guilhermenovais/tp2-robotica/screenshots/C03.png

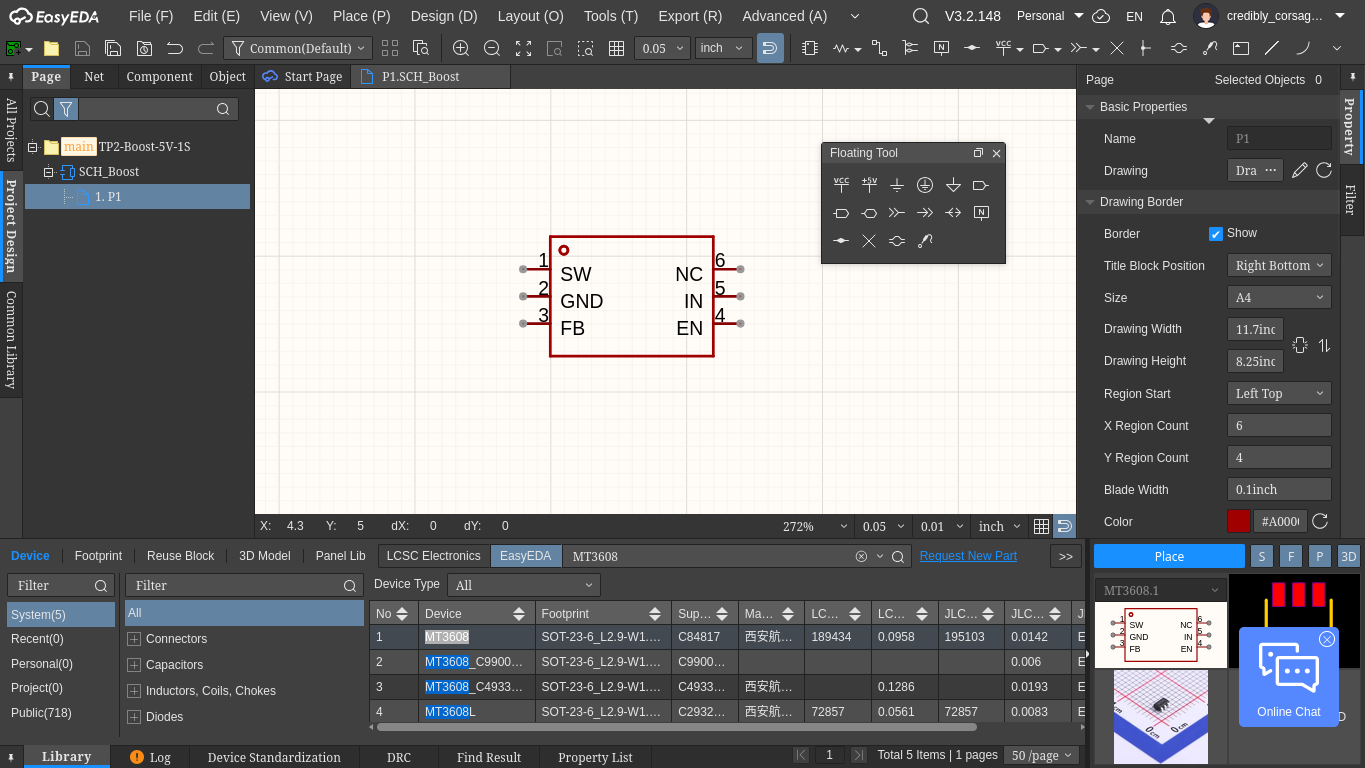
screenshots/C03.png
