guilhermenovais/tp2-robotica/screenshots/C04.png

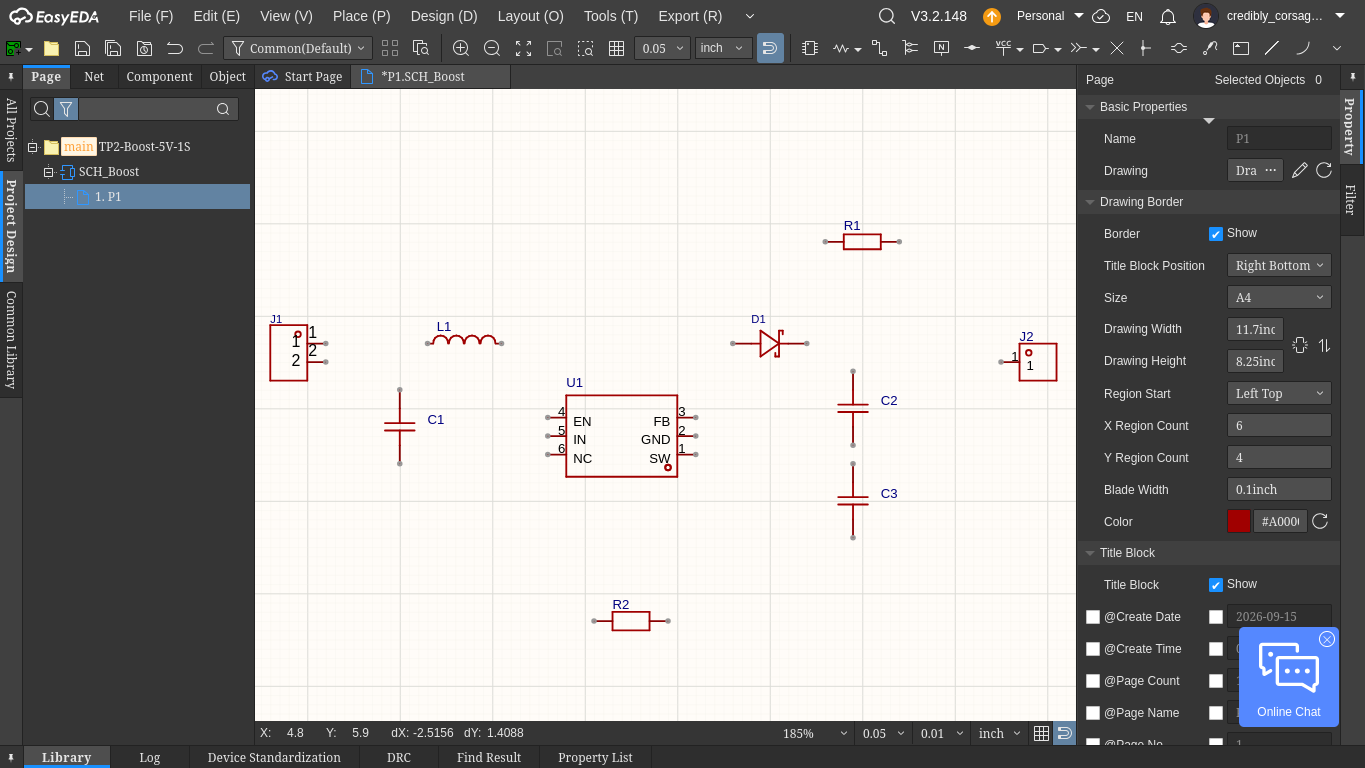
screenshots/C04.png
