guilhermenovais/tp2-robotica/screenshots/C09-antes-das-correcoes.png

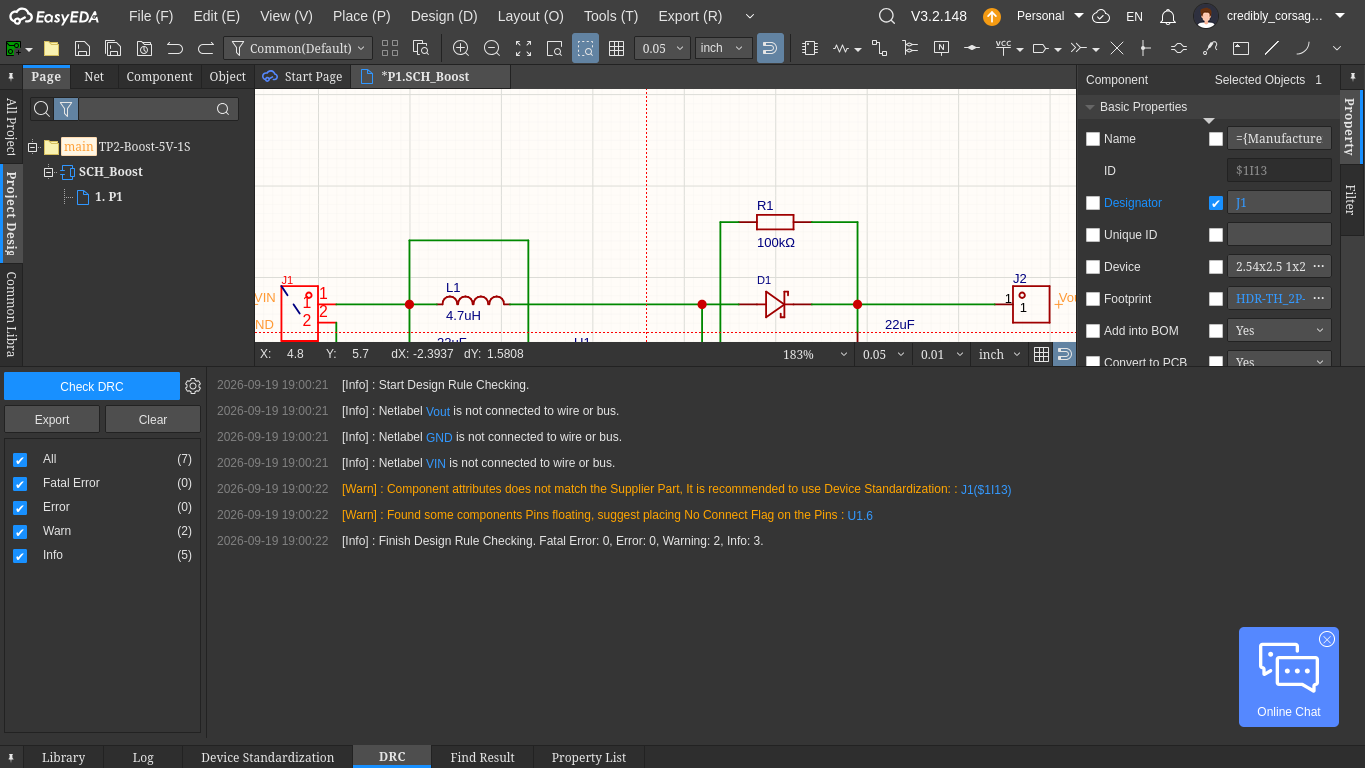
screenshots/C09-antes-das-correcoes.png
