guilhermenovais/tp2-robotica/screenshots/C09.png

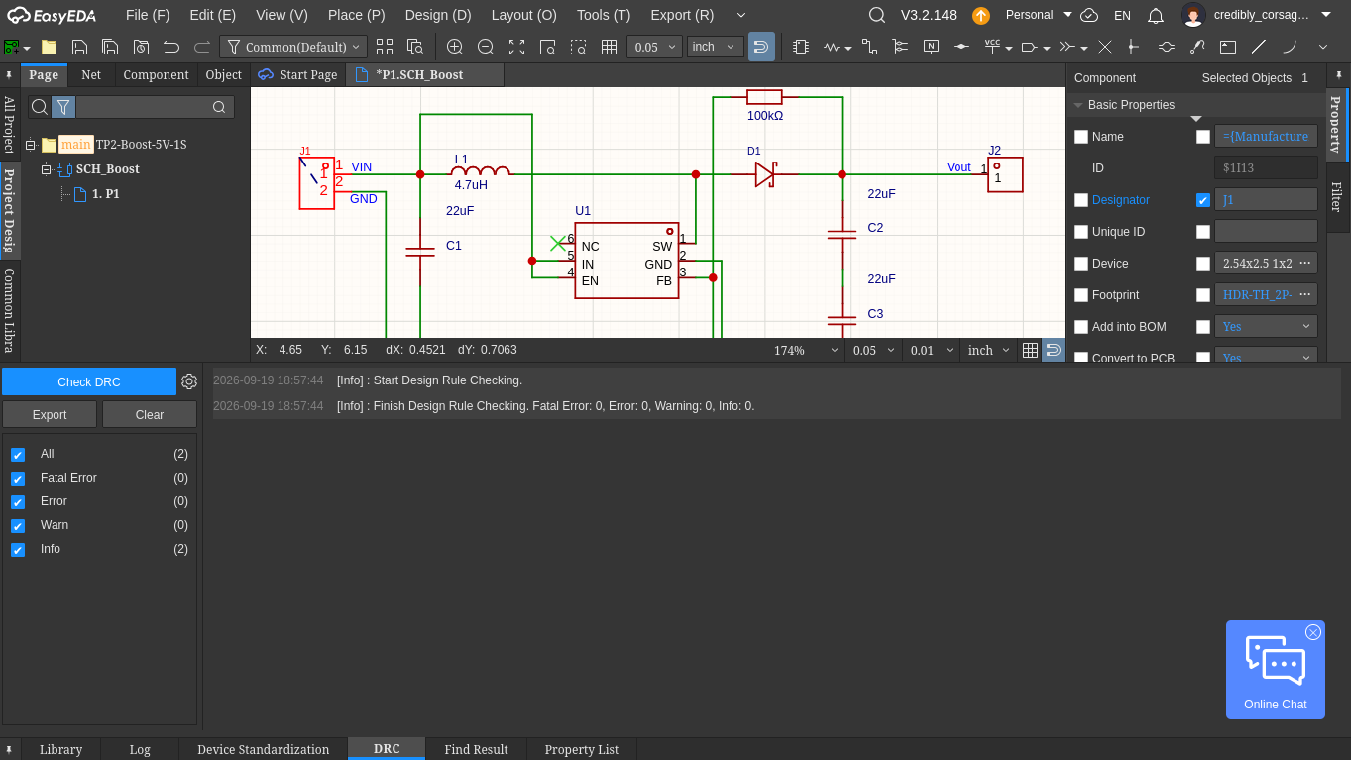
screenshots/C09.png
