guilhermenovais/tp2-robotica/screenshots/C12.png

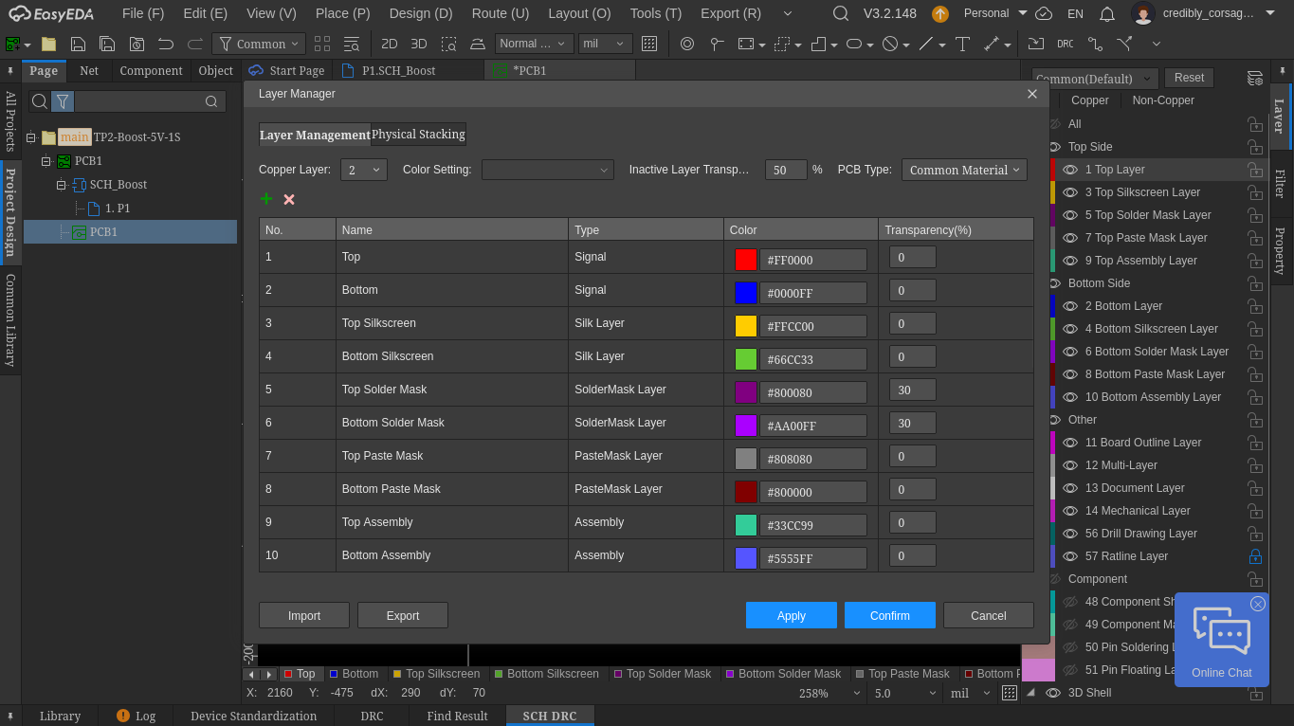
screenshots/C12.png
