guilhermenovais/tp2-robotica/screenshots/C14.png

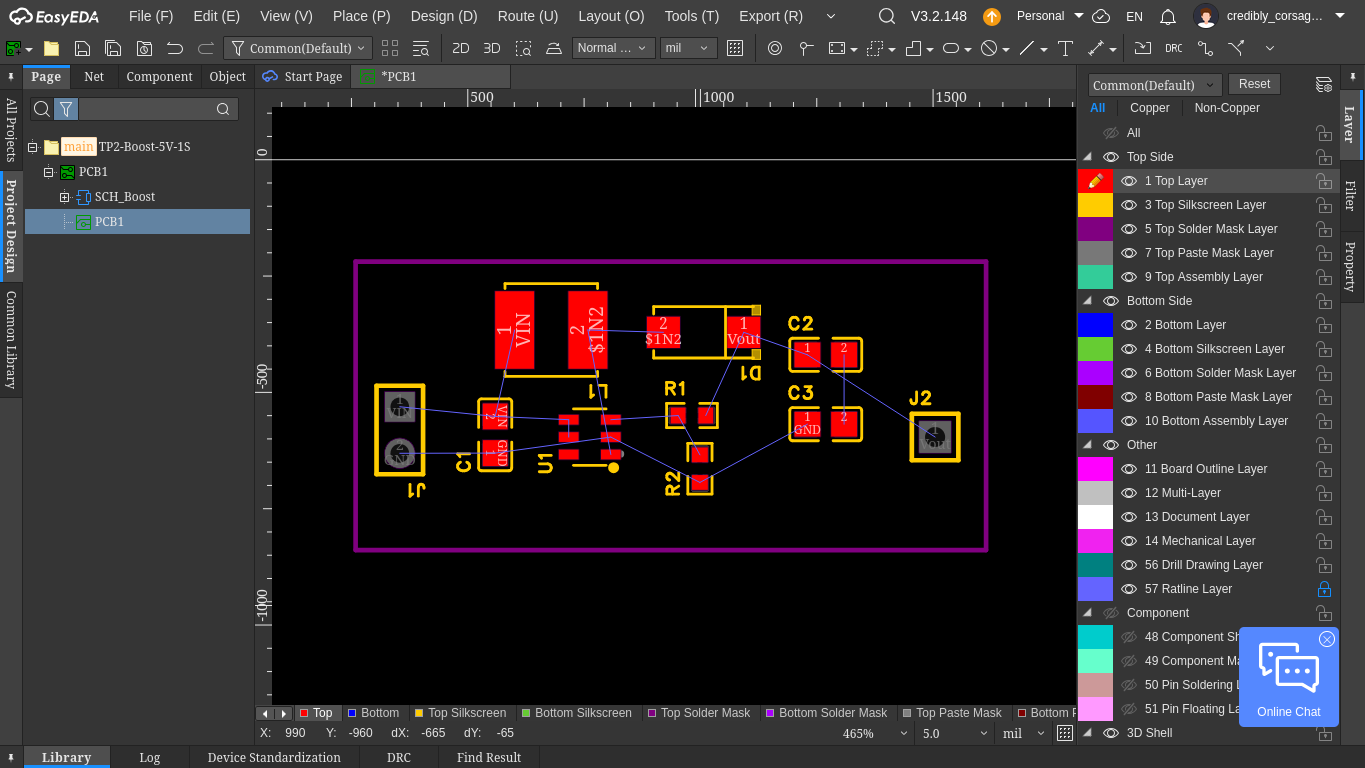
screenshots/C14.png
