guilhermenovais/tp2-robotica/screenshots/C15.png

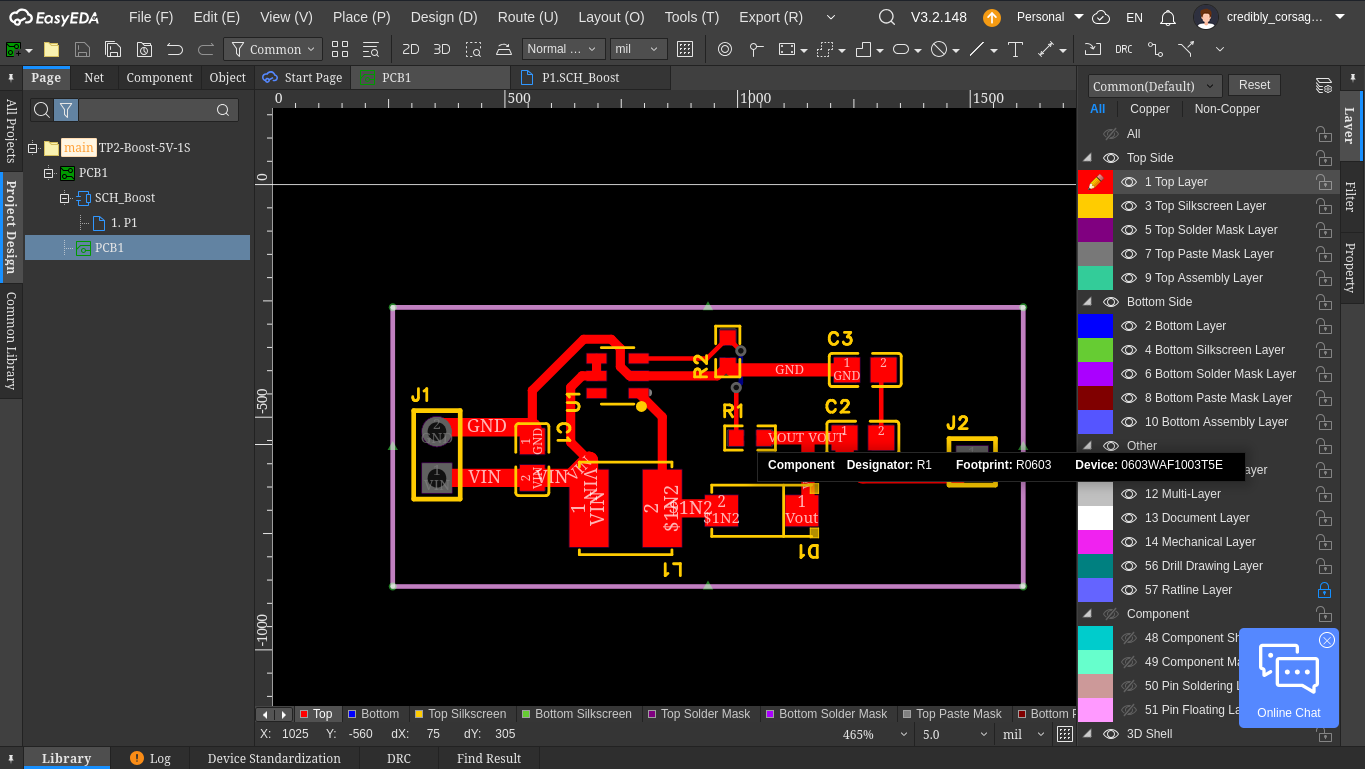
screenshots/C15.png
