guilhermenovais/tp2-robotica/screenshots/C17.png

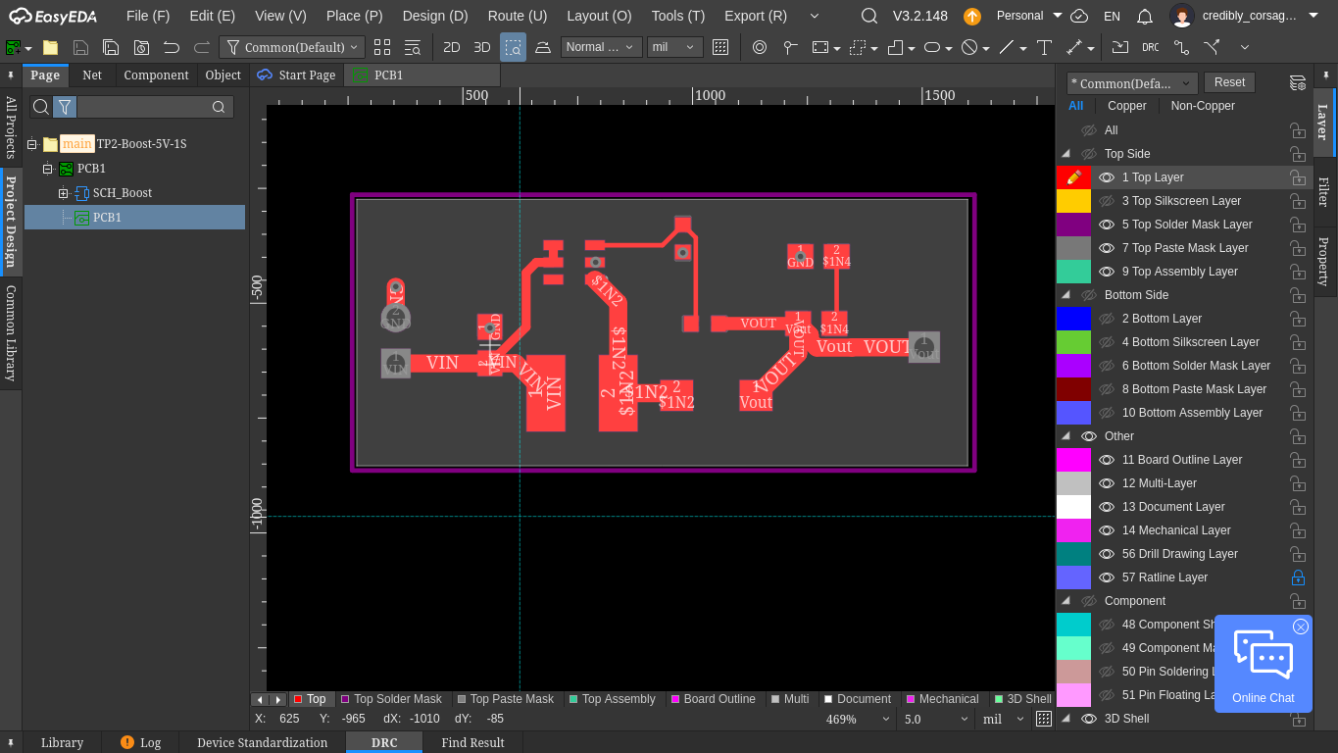
screenshots/C17.png
