guilhermenovais/tp2-robotica/screenshots/C18.png

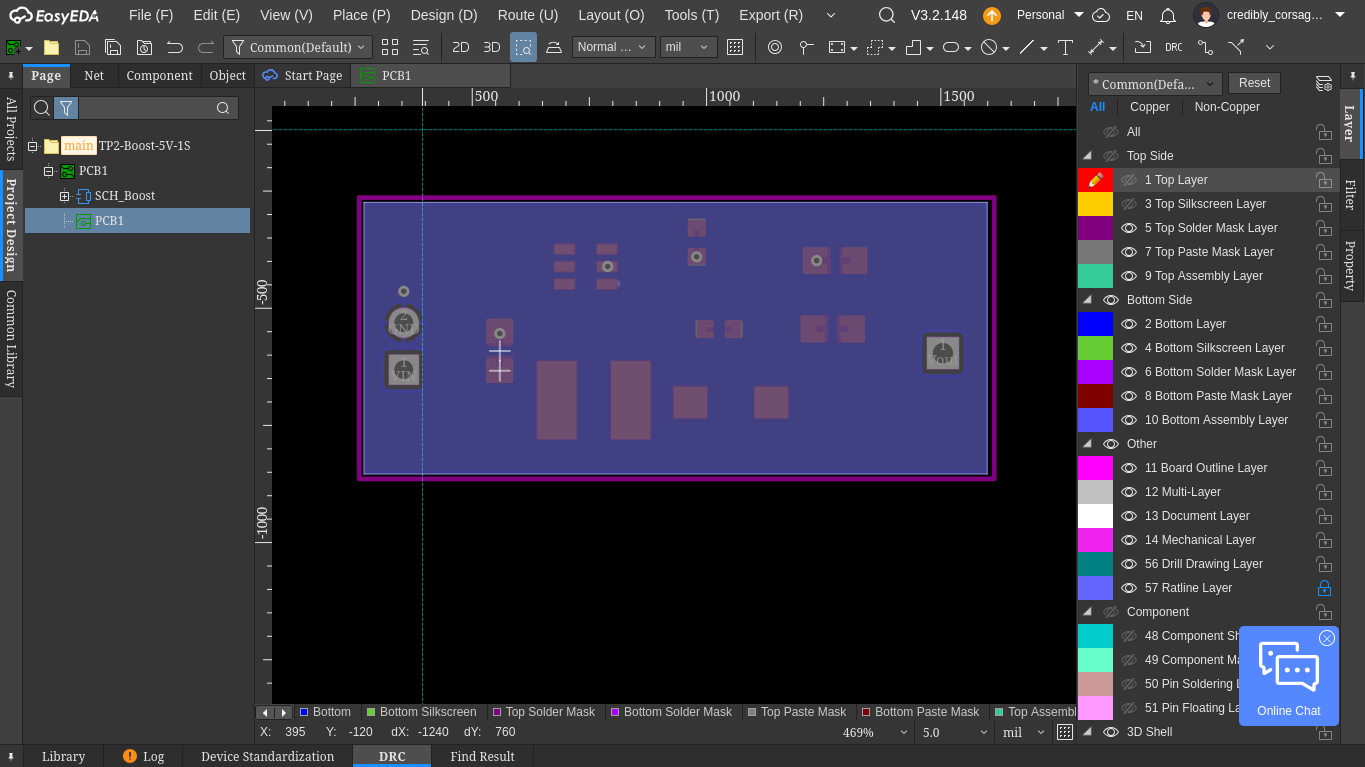
screenshots/C18.png
