guilhermenovais/tp2-robotica/screenshots/C20.png

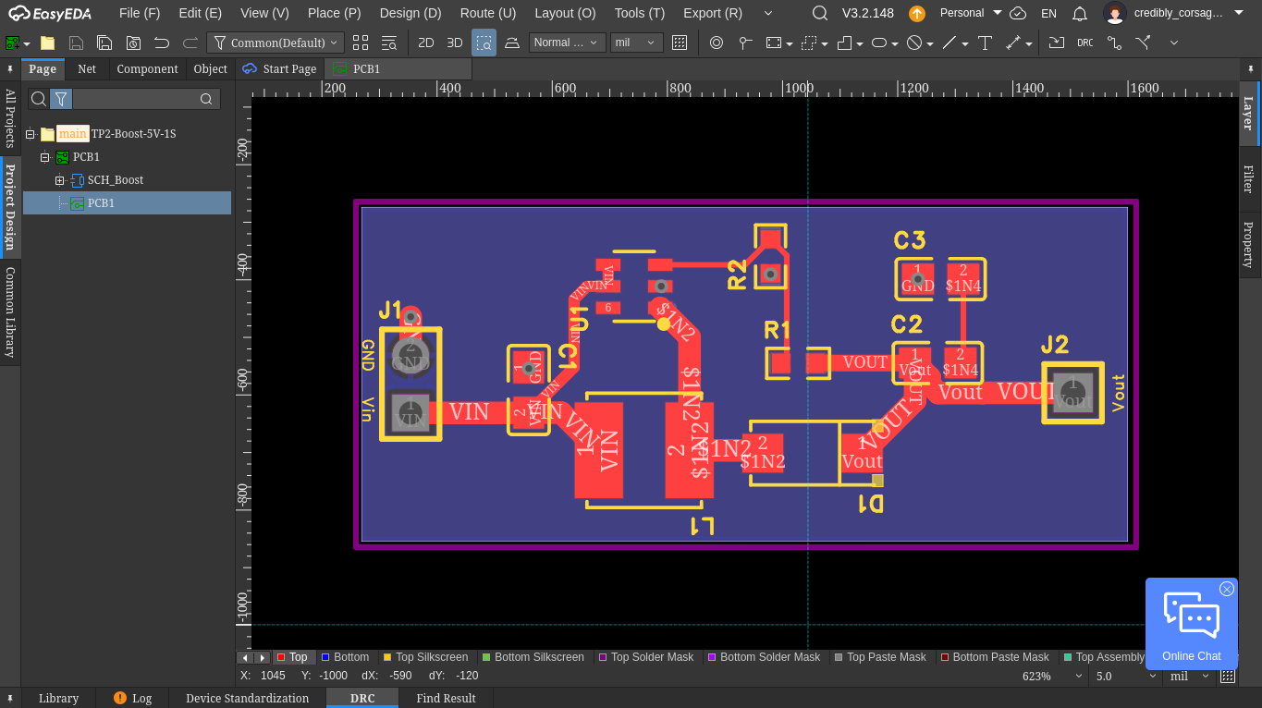
screenshots/C20.png
