guilhermenovais/tp2-robotica/screenshots/C22a.png

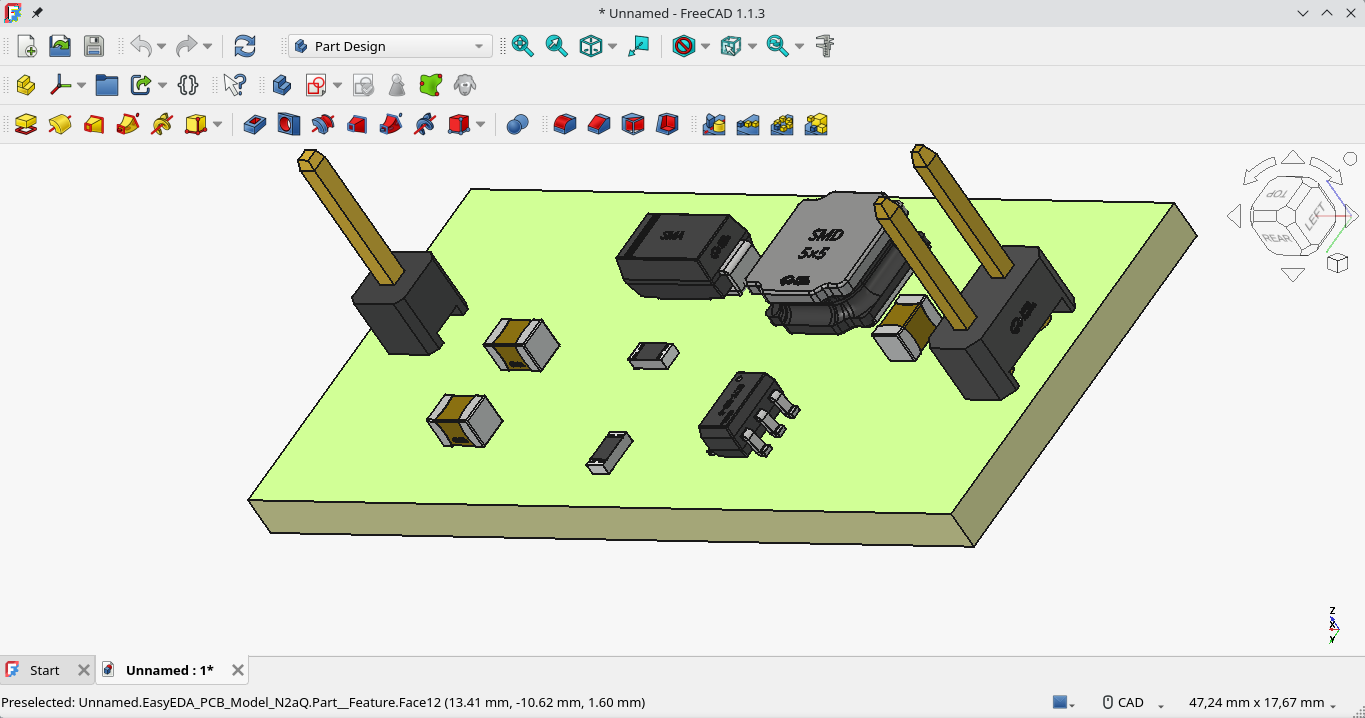
screenshots/C22a.png
