guilhermenovais/tp2-robotica/screenshots/C22b.png

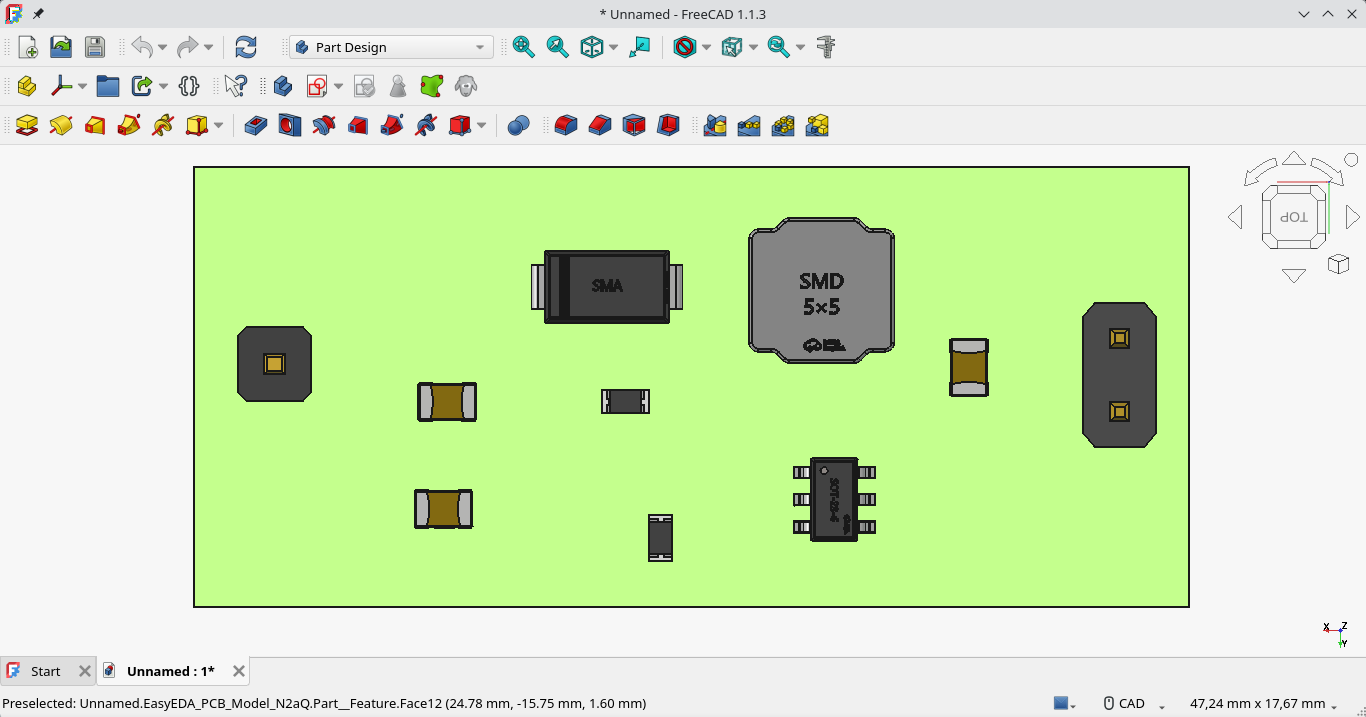
screenshots/C22b.png
