guilhermenovais/tp2-robotica/screenshots/D00g.png

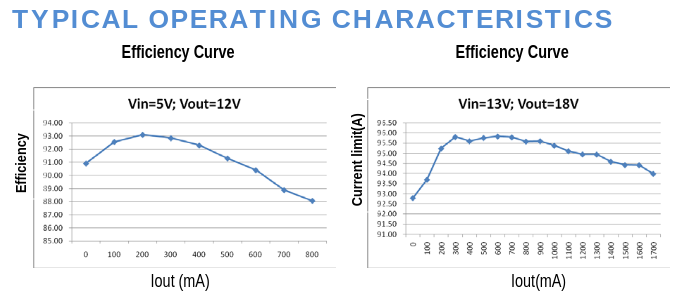
screenshots/D00g.png
