guilhermenovais/tp2-robotica/bom/BOM_PCB1_PCB1_2026-09-25.csv

No. | Quantity | Comment | Designator | Footprint | Value | Manufacturer Part | Manufacturer | Supplier Part | Supplier
1 | 3 | 22uF | C1,C2,C3 | C0805 | 22uF | CS2012X5R226M160NRE | SAMWHA(三和) | C2918507 | LCSC
2 | 1 | SS54 | D1 | SMA_L4.4-W2.6-LS5.0-RD |  | SS54 | DongChen(东晨) | C55127284 | LCSC
3 | 1 | 2.54x2.5 1x2P PA6.0 PC3.0 L11.6 | J1 | HDR-TH_2P-P2.54-V-M-R2-C1-S2.54_3 |  | 2.54x2.5 1x2P PA6.0 PC3.0 L11.6 | JMEconn(文章济美) | C55829673 | LCSC
4 | 1 | PH2.54-1X1P-H25 | J2 | HDR-TH_1P-P2.54-V-M |  | PH2.54-1X1P-H25 | JXTCONN(聚兴泰) | C42431799 | LCSC
5 | 1 | 4.7uH | L1 | IND-SMD_L5.0-W5.0 | 4.7uH | CKCS5040-4.7uH/M | CENKER(岑科) | C354606 | LCSC
6 | 1 | 100kΩ | R1 | R0603 | 100kΩ | 0603WAF1003T5E | UNI-ROYAL(厚声) | C25803 | LCSC
7 | 1 | 13.7kΩ | R2 | R0603 | 13.7kΩ | RC0603DR-0713K7L | YAGEO(国巨) | C858841 | LCSC
8 | 1 | MT3608 | U1 | SOT-23-6_L2.9-W1.6-P0.95-LS2.8-BL |  | MT3608 | 西安航天民芯 | C84817 | LCSC
