guilhermenovais/tp2-robotica/3d/3D_PCB1_2026-09-25.step

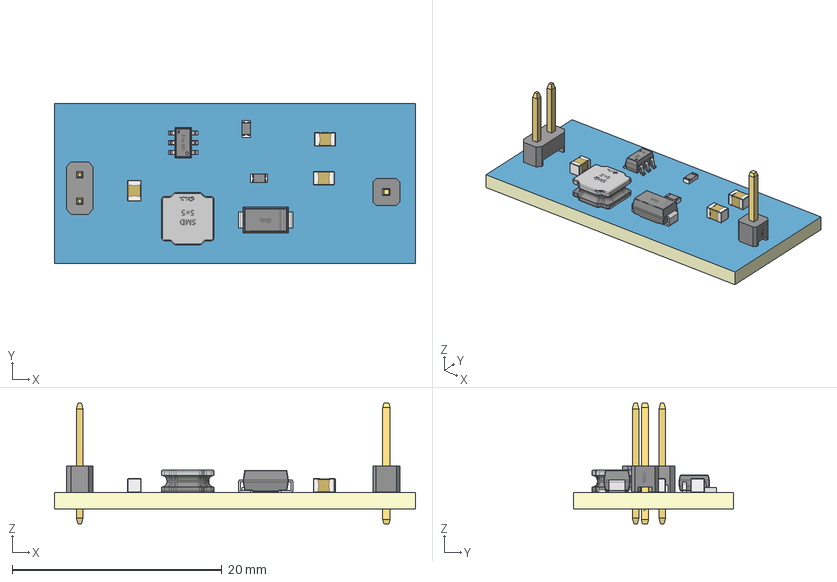
[picture p40: CAD file, 2026-09-27]
3d/3D_PCB1_2026-09-25.step
34.4 x 15.2 x 11.5 mm
Board~N2aQ
TopCopper~N2aQ
BottomCopper~N2aQ
TopSilkscreen~N2aQ
BottomSilkscreen~N2aQ
TopFpcStiffener~N2aQ
BottomFpcStiffener~N2aQ
C0805~C0805_L2.0-W1.3-H1.3~ixx3 x 3
SMA_L4.4-W2.6-LS5.0-RD~SMA_L4.4-W2.6-LS5.0-RD~Od2N
R0603~R0603~4STx x 2
IND-SMD_L5.0-W5.0~IND-SMD_L5.0-W5.0-H2.1~ijPo
SOT-23-6_L2.9-W1.6-P0.95-LS2.8-BL~SOT-23-6_L2.9-W1.6-H1.5-LS2.8-P0.95~2Sc5
HDR-TH_1P-P2.54-V-M~HDR2.54-M-LI-1X1P~Q9Yo
HDR-TH_2P-P2.54-V-M-R2-C1-S2.54_3~HDR-TH_2P-P2.54-V-M-R2-C1-S2.54_3~B1Dh
