guilhermenovais/tp2-robotica/pdf/PCB_PCB1_2026-09-25.pdf

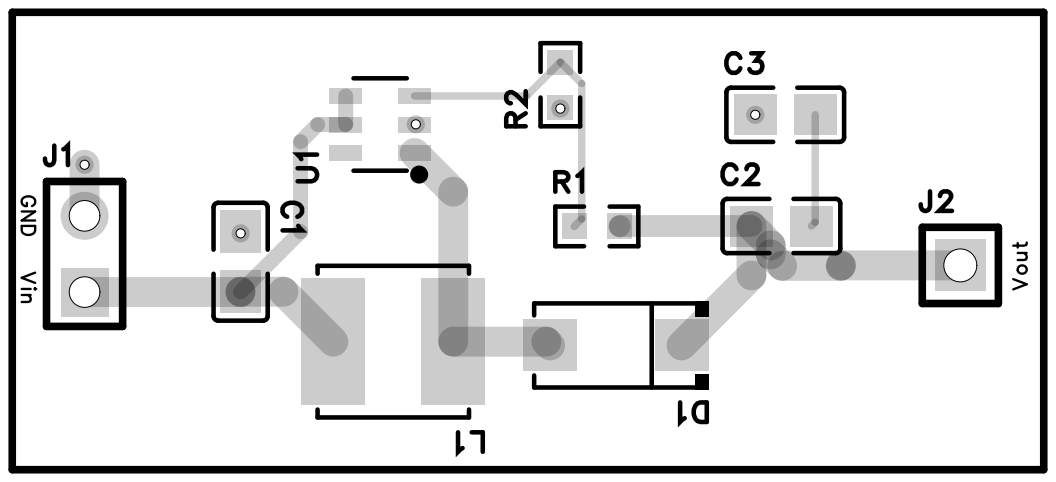
[picture p42: page 4]
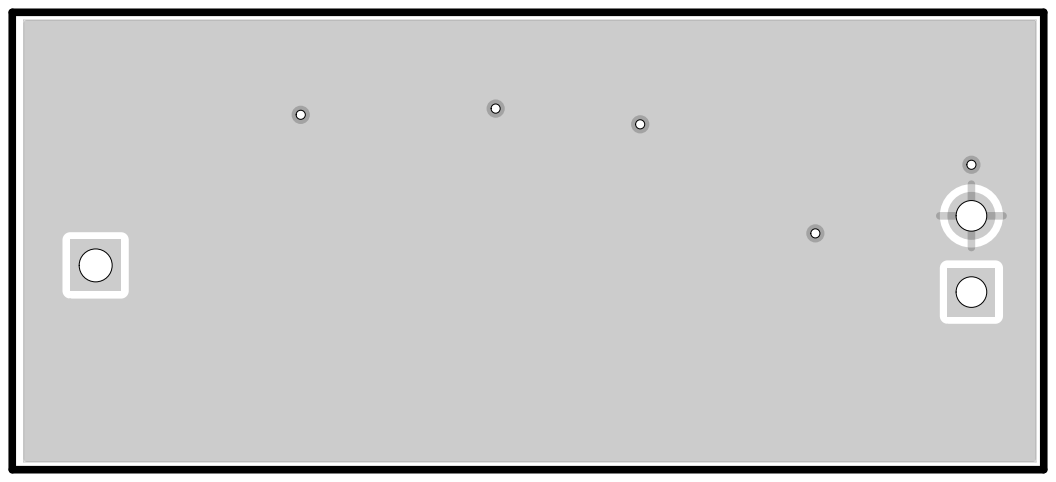
[picture p43: page 5]
